zlittell/Macro9PadHW/Macropad9key.kicad_pcb

## KiCad design Macropad9key.kicad_pcb (2020-09-02)

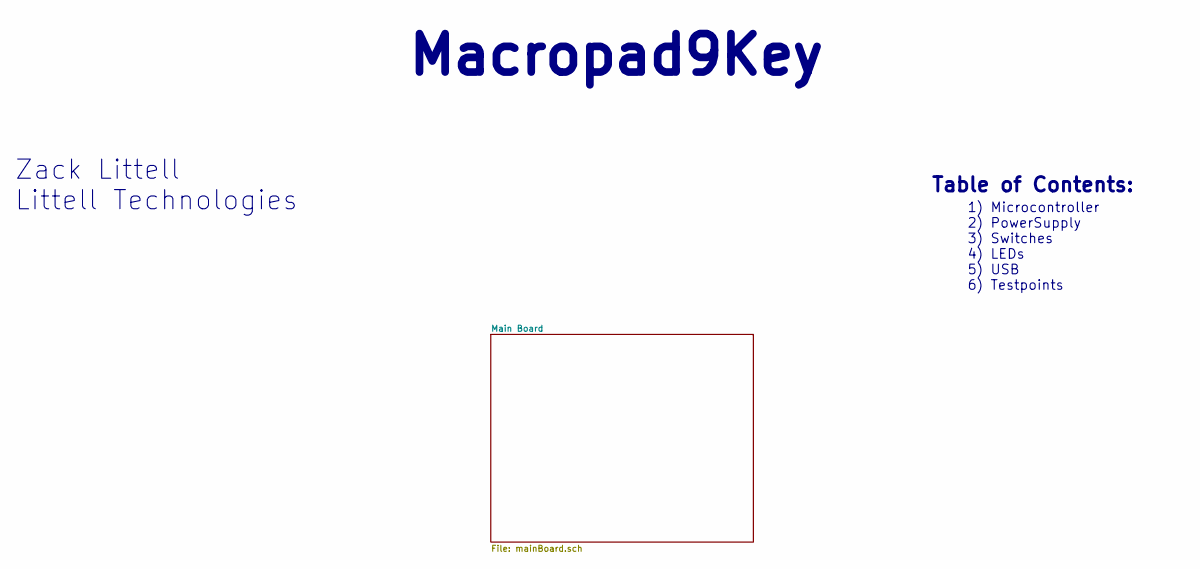
[picture p1: schematic Macropad9key.sch]

Notes on the sheet:
Macropad9Key
Zack Littell
Littell Technologies
Table of Contents:
1) Microcontroller 2) PowerSupply 3) Switches 4) LEDs 5) USB 6) Testpoints

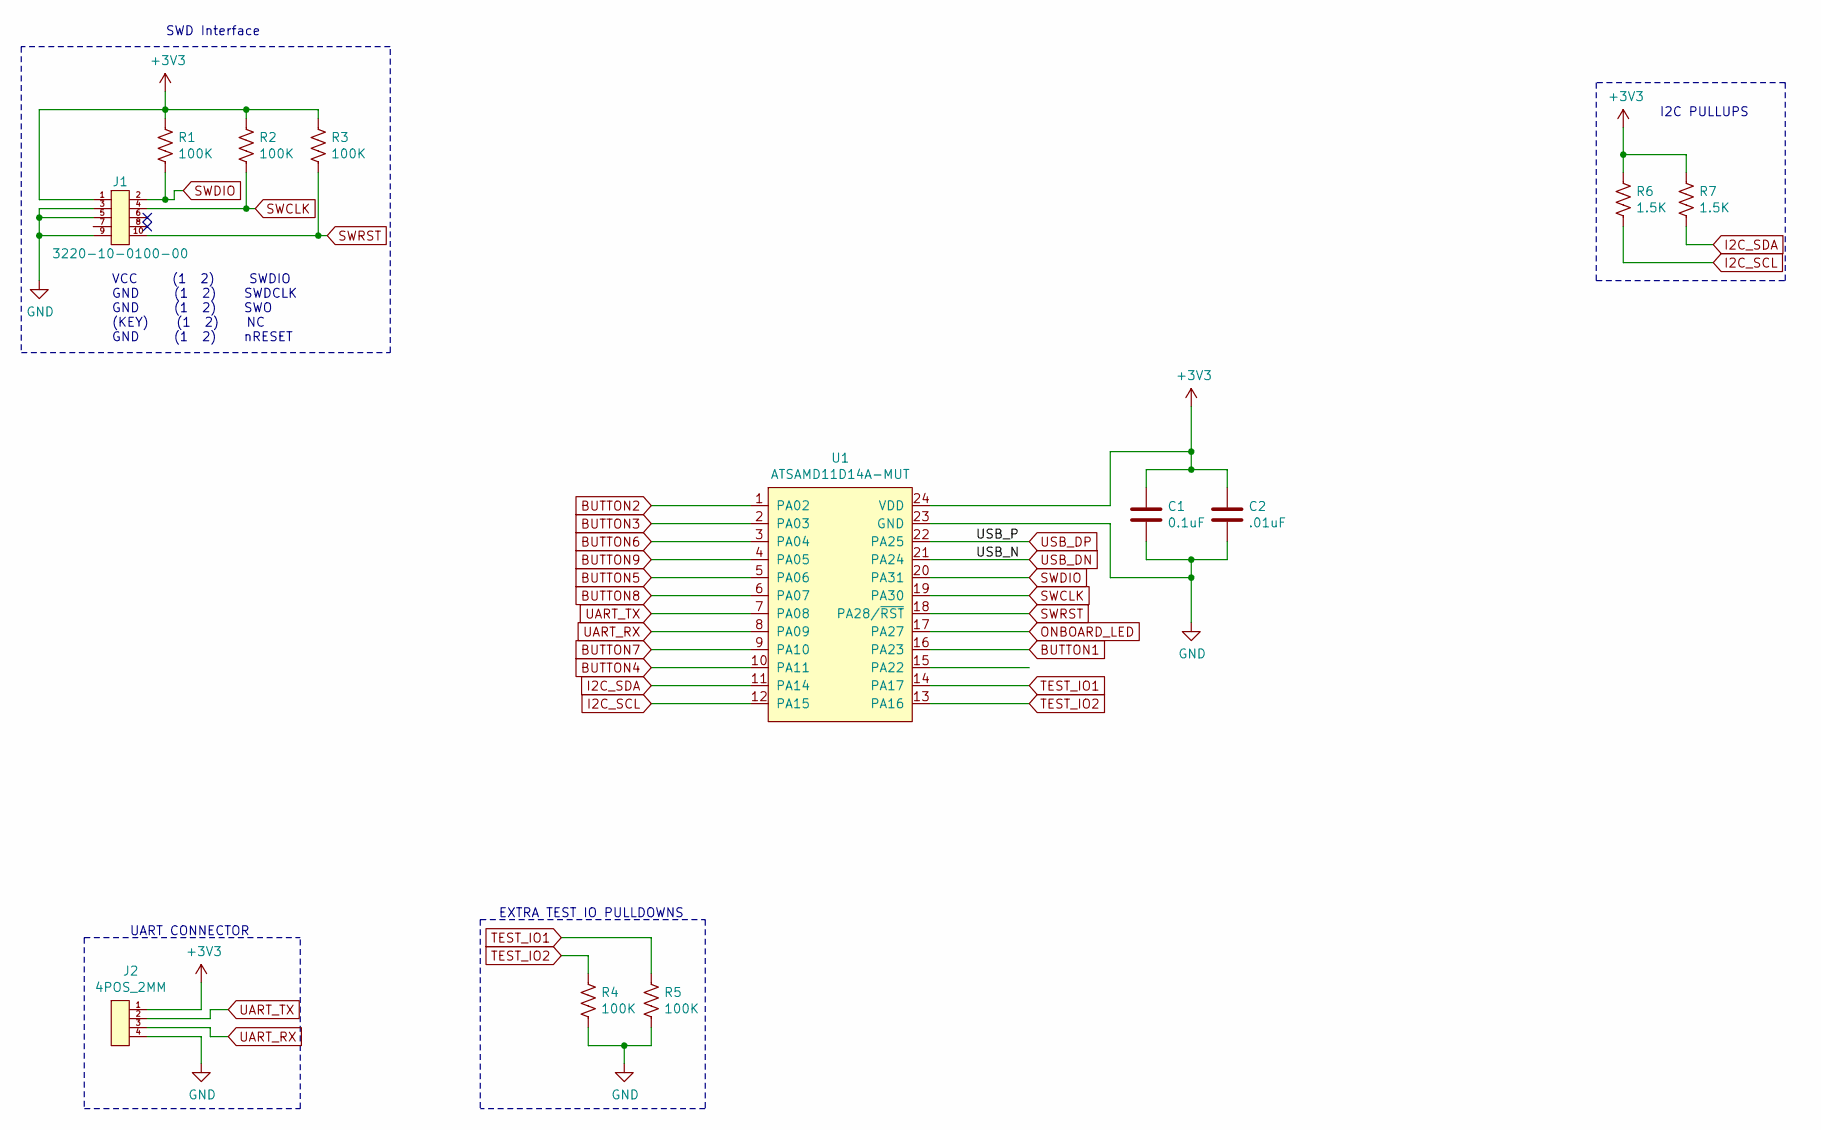
[picture p2: schematic Microcontroller.sch, Macropad9Key]

Parts:
C1: 0.1uF; C_0402_1005Metric
C2: .01uF; C_0402_1005Metric
J1: 3220-10-0100-00
J2: 4POS_2MM
R1, R2, R3, R4, R5: 100K; R_0603_1608Metric
R6, R7: 1.5K; R_0603_1608Metric
U1: ATSAMD11D14A-MUT; QFN-24-1EP_4x4mm_P0.5mm_EP2.6x2.6mm

Connections:
+3V3: C1.1, C2.1, J1.1, J2.1, R1.1, R2.1, R3.1, R6.1, R7.1, U1.24 (VDD); also elsewhere on the board
BUTTON1: U1.16 (PA23); also elsewhere on the board
BUTTON2: U1.1 (PA02); also elsewhere on the board
BUTTON3: U1.2 (PA03); also elsewhere on the board
BUTTON4: U1.10 (PA11); also elsewhere on the board
BUTTON5: U1.5 (PA06); also elsewhere on the board
BUTTON6: U1.3 (PA04); also elsewhere on the board
BUTTON7: U1.9 (PA10); also elsewhere on the board
BUTTON8: U1.6 (PA07); also elsewhere on the board
BUTTON9: U1.4 (PA05); also elsewhere on the board
GND: C1.2, C2.2, J1.3, J1.5, J1.9, J2.4, R4.2, R5.2, U1.23 (GND); also elsewhere on the board
I2C_SCL: R6.2, U1.12 (PA15); also elsewhere on the board
I2C_SDA: R7.2, U1.11 (PA14); also elsewhere on the board
ONBOARD_LED: U1.17 (PA27); also elsewhere on the board
SWCLK: J1.4, R2.2, U1.19 (PA30); also elsewhere on the board
SWDIO: J1.2, R1.2, U1.20 (PA31); also elsewhere on the board
SWRST: J1.10, R3.2, U1.18 (PA28/~RST); also elsewhere on the board
TEST_IO1: R5.1, U1.14 (PA17); also elsewhere on the board
TEST_IO2: R4.1, U1.13 (PA16); also elsewhere on the board
UART_RX: J2.3, U1.8 (PA09); also elsewhere on the board
UART_TX: J2.2, U1.7 (PA08); also elsewhere on the board
USB_DN: U1.21 (PA24); also elsewhere on the board
USB_DP: U1.22 (PA25); also elsewhere on the board

Notes on the sheet:
I2C PULLUPS
VCC (1 2) SWDIO GND (1 2) SWDCLK GND (1 2) SWO (KEY) (1 2) NC GND (1 2) nRESET
SWD Interface
UART CONNECTOR
EXTRA TEST IO PULLDOWNS

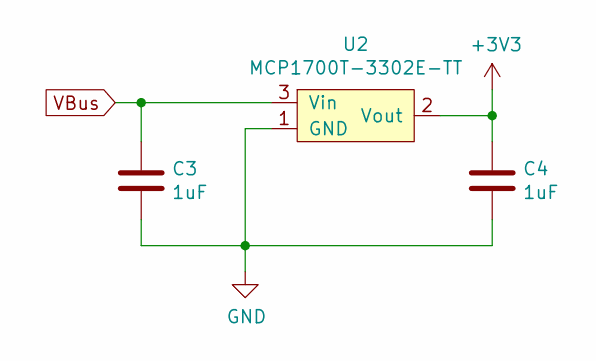
[picture p3: schematic PowerSupply.sch, Macropad9Key]

Parts:
C3, C4: 1uF; C_0603_1608Metric
U2: MCP1700T-3302E-TT; SOT-23

Connections:
+3V3: C4.1, U2.2 (Vout); also elsewhere on the board
GND: C3.2, C4.2, U2.1 (GND); also elsewhere on the board
VBus: C3.1, U2.3 (Vin); also elsewhere on the board

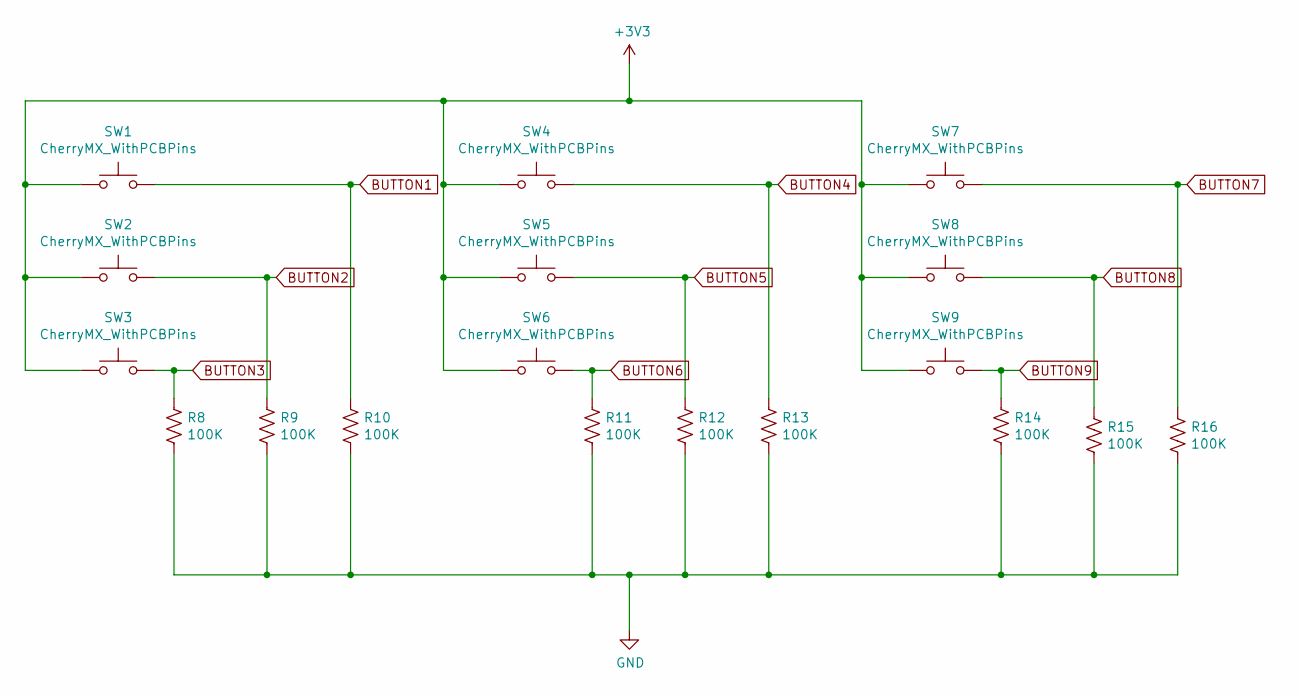
[picture p4: schematic Switches.sch, Macropad9Key]

Parts:
R8, R9, R10, R11, R12, R13, R14, R15, R16: 100K; R_0603_1608Metric
SW1, SW2, SW3, SW4, SW5, SW6, SW7, SW8, SW9: CherryMX_WithPCBPins; SW_Cherry_MX_1.00u_PCB

Connections:
+3V3: SW1.1, SW2.1, SW3.1, SW4.1, SW5.1, SW6.1, SW7.1, SW8.1, SW9.1; also elsewhere on the board
BUTTON1: R10.1, SW1.2; also elsewhere on the board
BUTTON2: R9.1, SW2.2; also elsewhere on the board
BUTTON3: R8.1, SW3.2; also elsewhere on the board
BUTTON4: R13.1, SW4.2; also elsewhere on the board
BUTTON5: R12.1, SW5.2; also elsewhere on the board
BUTTON6: R11.1, SW6.2; also elsewhere on the board
BUTTON7: R16.1, SW7.2; also elsewhere on the board
BUTTON8: R15.1, SW8.2; also elsewhere on the board
BUTTON9: R14.1, SW9.2; also elsewhere on the board
GND: R8.2, R9.2, R10.2, R11.2, R12.2, R13.2, R14.2, R15.2, R16.2; also elsewhere on the board

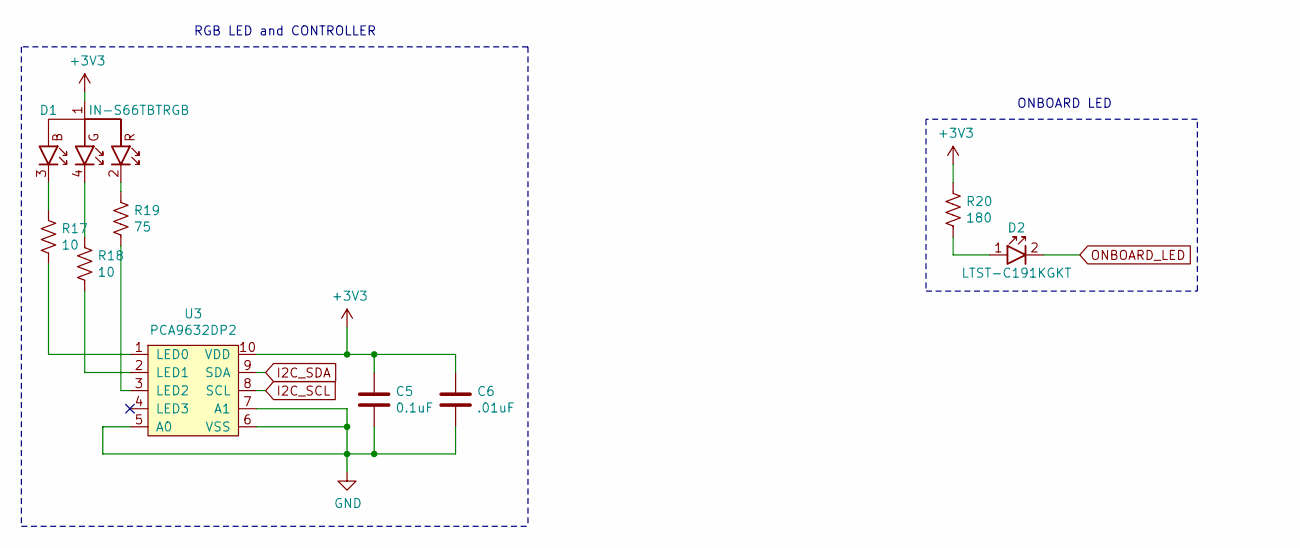
[picture p5: schematic LED.sch, Macropad9Key]

Parts:
C5: 0.1uF; C_0402_1005Metric
C6: .01uF; C_0402_1005Metric
D1: IN-S66TBTRGB; 0606_1616Metric
D2: LTST-C191KGKT; LED_0603_1608Metric
R17, R18: 10; R_0603_1608Metric
R19: 75; R_0603_1608Metric
R20: 180; R_0603_1608Metric
U3: PCA9632DP2; TSSOP-10_3x3mm_P0.5mm

Connections:
+3V3: C5.1, C6.1, D1.1 (CA), R20.1, U3.10 (VDD); also elsewhere on the board
GND: C5.2, C6.2, U3.5 (A0), U3.6 (VSS), U3.7 (A1); also elsewhere on the board
I2C_SCL: U3.8 (SCL); also elsewhere on the board
I2C_SDA: U3.9 (SDA); also elsewhere on the board
unnamed: D1.2 (R), R19.1
unnamed: D1.3 (B), R17.2
unnamed: D1.4 (G), R18.2
unnamed: D2.1 (ANNODE), R20.2
unnamed: R17.1, U3.1 (LED0)
unnamed: R18.1, U3.2 (LED1)
unnamed: R19.2, U3.3 (LED2)
ONBOARD_LED: D2.2 (Cathode); also elsewhere on the board

Notes on the sheet:
ONBOARD LED
RGB LED and CONTROLLER

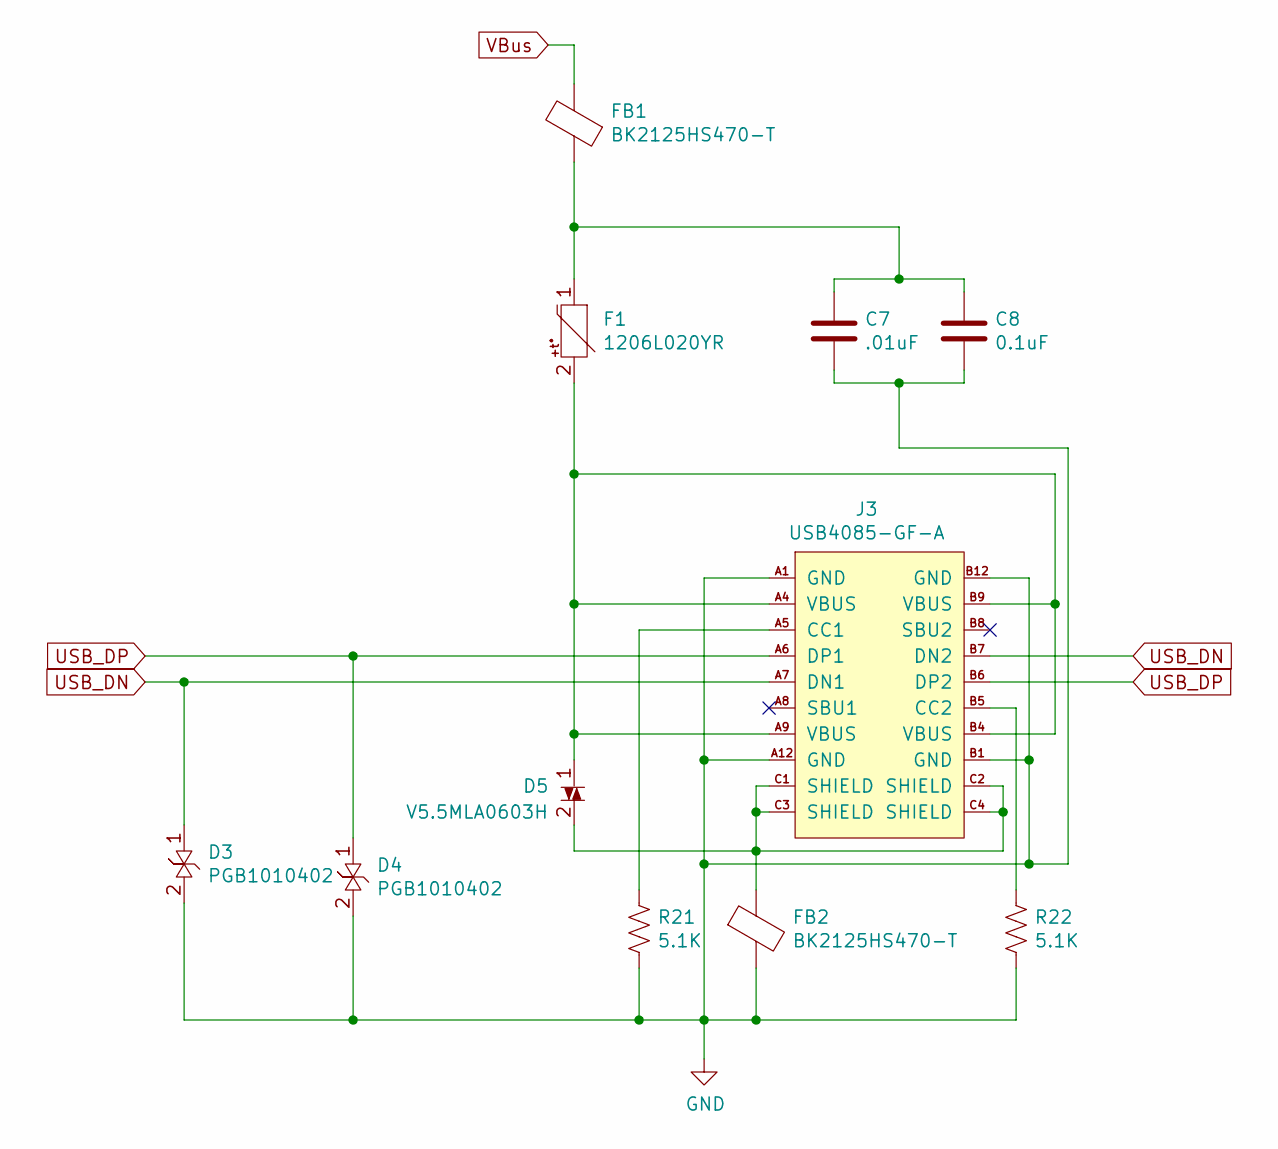
[picture p6: schematic USBConnector.sch, Macropad9Key]

Parts:
C7: .01uF; C_0402_1005Metric
C8: 0.1uF; C_0402_1005Metric
D3, D4: PGB1010402; D_0402_1005Metric_NP
D5: V5.5MLA0603H; D_0603_1608Metric_NP
F1: 1206L020YR; Fuse_1206_3216Metric
FB1, FB2: BK2125HS470-T; L_0805_2012Metric
J3: USB4085-GF-A
R21, R22: 5.1K; R_0603_1608Metric

Connections:
GND: C7.2, C8.2, D3.2, D4.2, FB2.2, J3.A1 (GND), J3.A12 (GND), J3.B1 (GND), J3.B12 (GND), R21.2, R22.2; also elsewhere on the board
unnamed: C7.1, C8.1, F1.1, FB1.1
unnamed: D5.1, F1.2, J3.A4 (VBUS), J3.A9 (VBUS), J3.B4 (VBUS), J3.B9 (VBUS)
unnamed: D5.2, FB2.1, J3.C1 (SHIELD), J3.C2 (SHIELD), J3.C3 (SHIELD), J3.C4 (SHIELD)
unnamed: J3.A5 (CC1), R21.1
unnamed: J3.B5 (CC2), R22.1
USB_DN: D3.1, J3.A7 (DN1), J3.B7 (DN2); also elsewhere on the board
USB_DP: D4.1, J3.A6 (DP1), J3.B6 (DP2); also elsewhere on the board
VBus: FB1.2; also elsewhere on the board

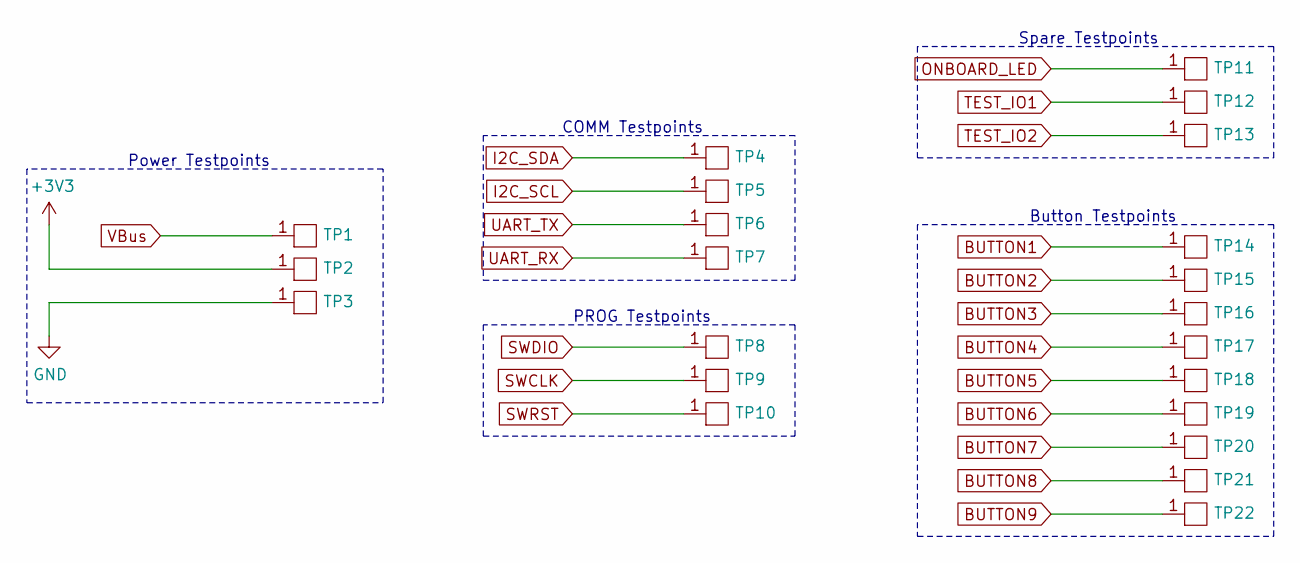
[picture p7: schematic testpoints.sch, Macropad9Key]

Parts:
TP1, TP2, TP3, TP4, TP5, TP6, TP7, TP8, TP9, TP10, TP11, TP12, TP13, TP14, TP15, TP16, TP17, TP18, TP19, TP20, TP21, TP22: TESTPOINT_50MILSQ

Connections:
+3V3: TP2.1; also elsewhere on the board
BUTTON1: TP14.1; also elsewhere on the board
BUTTON2: TP15.1; also elsewhere on the board
BUTTON3: TP16.1; also elsewhere on the board
BUTTON4: TP17.1; also elsewhere on the board
BUTTON5: TP18.1; also elsewhere on the board
BUTTON6: TP19.1; also elsewhere on the board
BUTTON7: TP20.1; also elsewhere on the board
BUTTON8: TP21.1; also elsewhere on the board
BUTTON9: TP22.1; also elsewhere on the board
GND: TP3.1; also elsewhere on the board
I2C_SCL: TP5.1; also elsewhere on the board
I2C_SDA: TP4.1; also elsewhere on the board
ONBOARD_LED: TP11.1; also elsewhere on the board
SWCLK: TP9.1; also elsewhere on the board
SWDIO: TP8.1; also elsewhere on the board
SWRST: TP10.1; also elsewhere on the board
TEST_IO1: TP12.1; also elsewhere on the board
TEST_IO2: TP13.1; also elsewhere on the board
UART_RX: TP7.1; also elsewhere on the board
UART_TX: TP6.1; also elsewhere on the board
VBus: TP1.1; also elsewhere on the board

Notes on the sheet:
Power Testpoints
COMM Testpoints
Spare Testpoints
PROG Testpoints
Button Testpoints

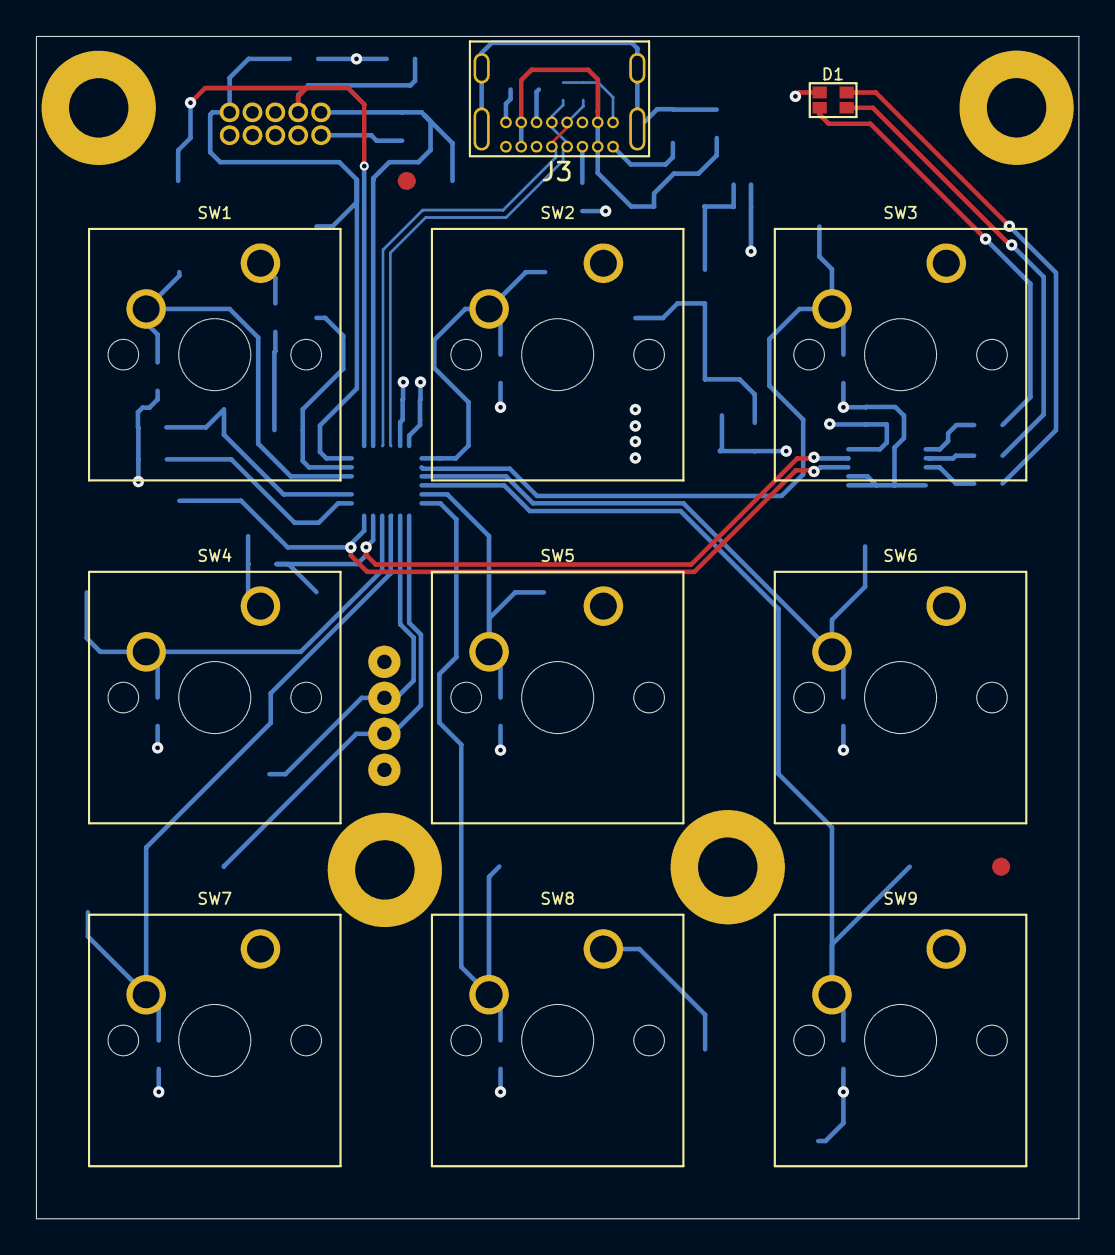
[picture p8: board Macropad9key.kicad_pcb from above]

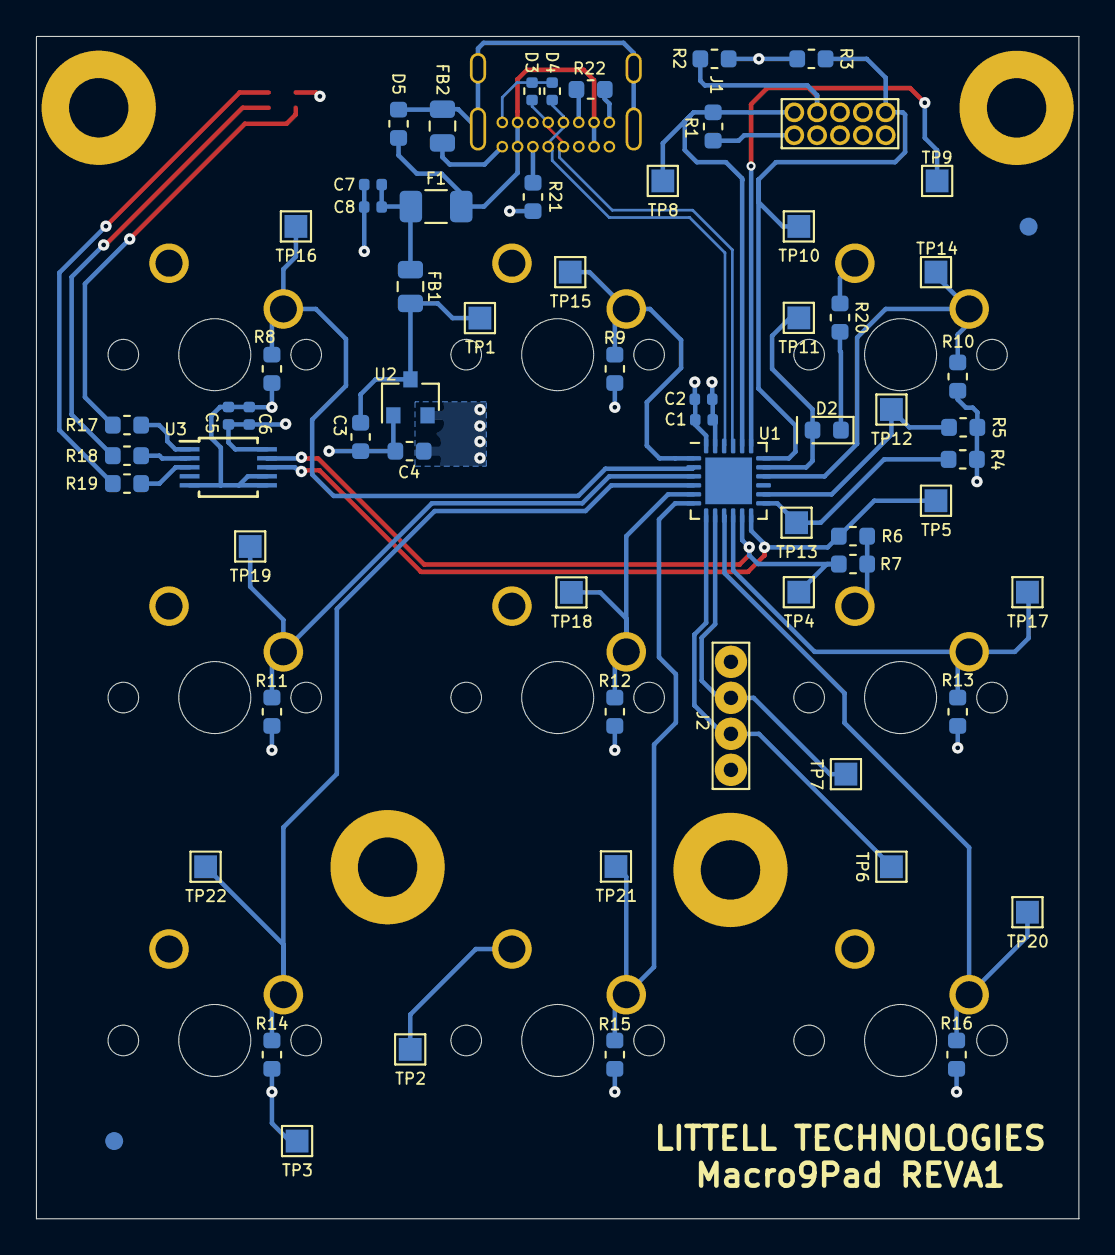
[picture p9: board Macropad9key.kicad_pcb from below]

Board: 4 copper layers, 57.9 x 65.7 mm, 75 parts (64 on the bottom side), 36 nets.
