zlittell/Macro9PadHW/(commit log)

2020-08-29 Schematic Done Starting PCB Initial Commit
    [LED.sch, Macropad9key.kicad_pcb, Macropad9key.sch, Microcontroller.sch, PowerSupply.sch, Switches.sch, USBConnector.sch, mainBoard.sch]
2020-08-29 Placed components, USB difference calc'd
    [Macropad9key.kicad_pcb]
2020-08-30 Initial layout complete. Pins moved to make layout easy
    [Macropad9key.kicad_pcb, Microcontroller.sch, PowerSupply.sch, USBConnector.sch, testpoints.sch]
2020-08-31 Silkscreen REFDES resized and aligned
    [Macropad9key.kicad_pcb, USBConnector.sch]
2020-08-31 Adjust assembly layer. Add Fiducial Marks on SMD side
    [Macropad9key.kicad_pcb]
2020-09-01 Create pcb export step file for MCAD.
2020-09-01 Shrink PCB, move LED to opposite corner top side
    [LED.sch, Macropad9key.kicad_pcb]
2020-09-02 Fix mounting screw hole under ICD header
    [Macropad9key.kicad_pcb]
2020-09-02 updated pcb 3d step file export
2020-09-02 Update titleblock, add fab notes, add drill table
    [Macropad9key.kicad_pcb]
2020-09-02 Gerbers for REVA1 created
    [Macropad9key.kicad_pcb]
2020-09-02 Add company and pcb name/rev to silk
    [Macropad9key.kicad_pcb]
2020-09-02 fix outputs having title block
    [Macropad9key.kicad_pcb]
